PaekHyun/HomeTempMonitor/epaper_preview.png

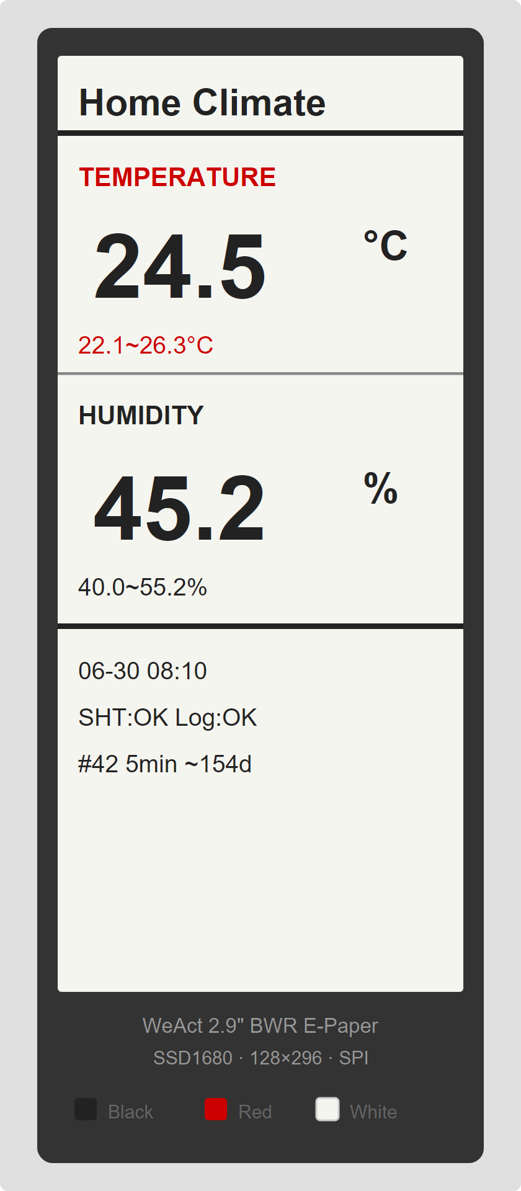
epaper_preview.png
