PaekHyun/HomeTempMonitor/(commit log)

2026-07-09 fix: 컴파일 에러 수정 (rotateLog 선언, ext1 wakeup, SHT40 begin)
    [DataLogger.h, HomeTempMonitor.ino]
2026-07-09 feat: 디버그 로그 강화 (웨이크업 원인, Step별 진행, 버튼상태, 배터리추정)
2026-07-09 debug: deep sleep 주석처리 + loop()에서 10초마다 재측정
2026-07-10 fix: DataLogger 시간 중복 +9h 제거 (RTC에 이미 KST 저장됨)
    [DataLogger.cpp]
2026-07-10 fix: 버튼 핀 최우선 풀업 설정 + 웨이크업 원인으로 WiFi 활성화
    [HomeTempMonitor.ino]
2026-07-21 feat: nanoESP32-C6용 .ino 추가 (핀맵 변경: I2C=GPIO6/7, SPI=GPIO2/3/4, Button=GPIO8)
2026-07-21 fix: nanoESP32-C6 RGB LED 끄기 추가 (GPIO8 버튼 공유 충돌 방지)
2026-07-21 docs: README 업데이트 (nanoESP32-C6 핀맵, RGB LED, 버튼, BOM, 변경이력 추가)
2026-07-21 feat: 16MB Flash 커스텀 파티션 테이블 추가, README 저장 용량 비교 업데이트
    [partitions_16mb.csv]
2026-07-21 refactor: .ino 파일 하나로 통합 (#ifdef로 XIAO/nano 보드 선택), nano .ino 삭제, .gitignore 추가
2026-07-21 docs: README 업데이트 - .ino 통합(#ifdef 보드 선택) 반영, 파일 구조/보드 선택 방법/Deep Sleep 매크로 설명 추가
2026-07-27 fix: e-paper 구동 수정 - 핀맵 Calendar 코드 기준 반영, SPI.begin() CS핀 추가, reset_ms 50→5 변경
    [HomeTempMonitor.ino]
2026-07-27 docs: README 핀맵 수정 - Calendar 작동 코드 기준 반영 (CS=6, DC=7, RST=0, BUSY=1, SCK=5), 디버그 로그/비교표/변경이력 업데이트
2026-07-27 HomeTempMonitor 수정
2026-07-28 refactor: 4색(BWRY) 활용, 168x384 전체 해상도 사용, 주석 코드 삭제, 체감온도/습도상태/WiFi상태/보드명 추가
2026-07-28 docs: README 업데이트 - 4색 BWRY 디스플레이, 168x384 레이아웃, 체감온도/습도상태 반영
